wandouuu/macroWAN/README.md

# vWAN-micropad
PCB design for personal macropad!
