wandouuu/macroWAN/macroWAN/vWAN-macropad.step

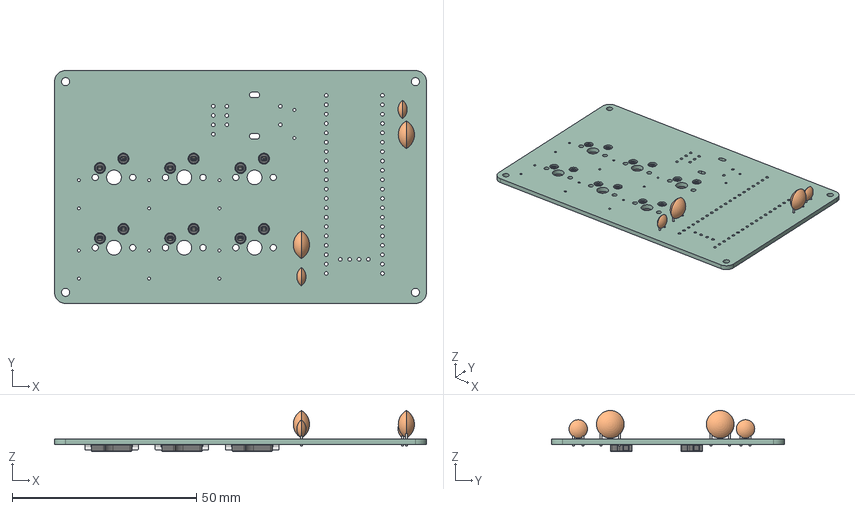
[picture p1: CAD file, 2025-09-18]
macroWAN/vWAN-macropad.step
100.8 x 63.1 x 11.1 mm
C_Disc_D7.5mm_W4.4mm_P5.00mm x 2
C_Disc_D5.0mm_W2.5mm_P2.50mm x 2
MX-Hotswap-Socket x 6
vWAN-macropad_PCB
