wandouuu/macroWAN/macroWAN/vWAN-macropad.kicad_pcb

## KiCad design macroWAN/vWAN-macropad.kicad_pcb (2026-01-08)

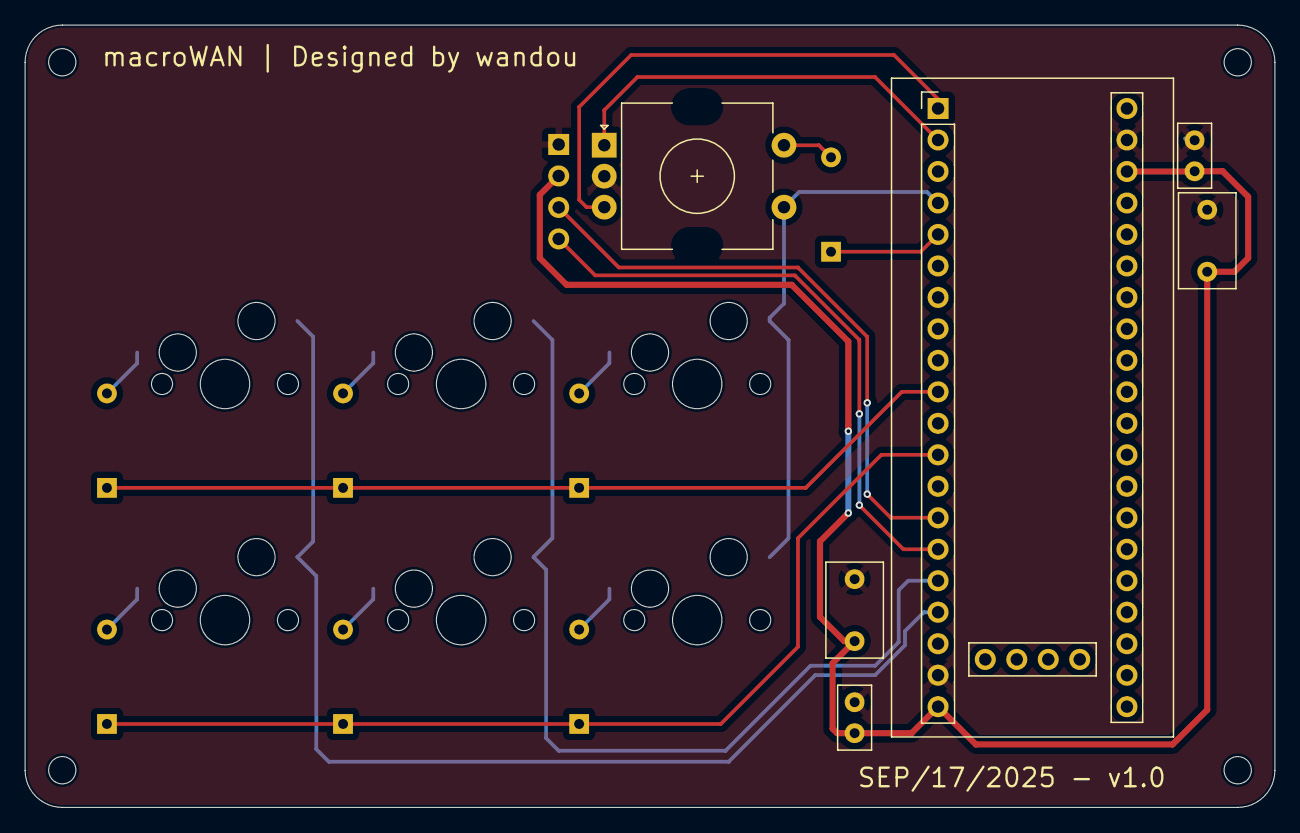
[picture p2: board vWAN-macropad.kicad_pcb from above]

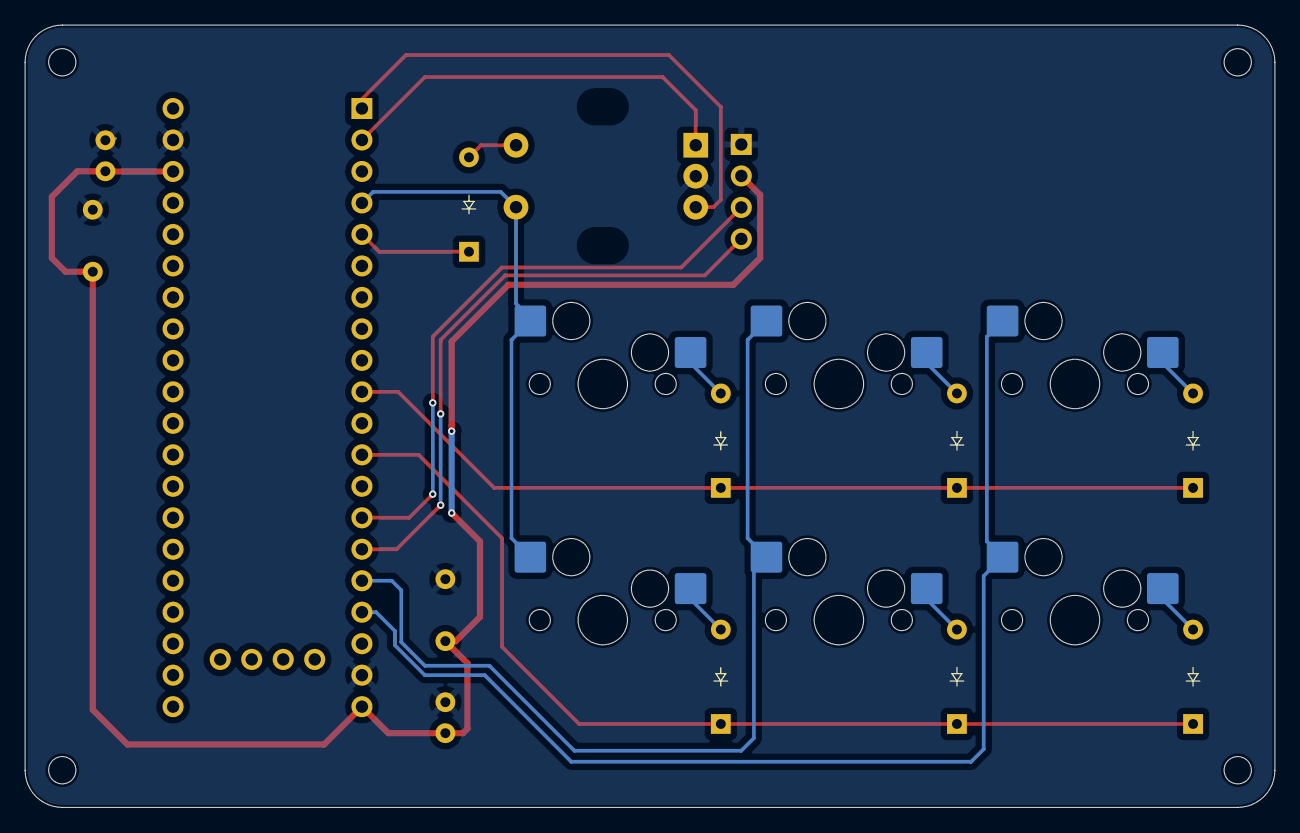
[picture p3: board vWAN-macropad.kicad_pcb from below]

Board: 2 copper layers, 100.8 x 63.1 mm, 24 parts (13 on the bottom side), 19 nets.

Parts:
C1, C2: 0.1uF; C_Disc_D5.0mm_W2.5mm_P2.50mm
C3, C4: 2.2uF; C_Disc_D7.5mm_W4.4mm_P5.00mm
D1, D2, D3, D4, D5, D6, D7: Diode; Diode_DO-35
H1, H2, H3, H4: MountingHole_Pad; MountingHole_2.2mm_M2_ISO7380
J1: OLED_128x32
SW1, SW2, SW3, SW4, SW5, SW6: Switch; MX-Hotswap-1U
SW7: RotaryEncoder_Switch; RotaryEncoder_EC11
U1: YAAJ_WeAct_BlackPill_Part_Like_SWD_Breakout; YAAJ_WeAct_BlackPill_SWD_2

Connections:
+3.3V: C1.2, C2.2, C3.2, C4.2, J1.2 (VCC), U1.20 (3V3), U1.38 (3V3)
Col 0: SW1.2, SW4.2, U1.17 (PB9)
Col 1: SW2.2, SW5.2, U1.16 (PB8)
Col 2: SW3.2, SW6.2, SW7.S1, U1.4 (PB15)
ENC_A: SW7.A, U1.2 (PB13)
ENC_B: SW7.B, U1.1 (PB12)
GND: C1.1, C2.1, C3.1, C4.1, J1.1 (GND), SW7.C, U1.19 (GND), U1.39 (GND)
unnamed: D1.2 (A), SW1.1
unnamed: D2.2 (A), SW2.1
unnamed: D3.2 (A), SW3.1
unnamed: D4.2 (A), SW4.1
unnamed: D5.2 (A), SW5.1
unnamed: D6.2 (A), SW6.1
unnamed: D7.2 (A), SW7.S2
Row 0: D7.1 (K), U1.5 (PA8)
Row 1: D1.1 (K), D2.1 (K), D3.1 (K), U1.10 (PA15)
Row 2: D4.1 (K), D5.1 (K), D6.1 (K), U1.12 (PB4)
SCL-SCK: J1.3 (SCL), U1.14 (PB6)
SDA: J1.4 (SDA), U1.15 (PB7)
