wandouuu/macroWAN/firmware/Core/Src/main.c

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
/* Includes ------------------------------------------------------------------*/
#include "main.h"


/* USER CODE BEGIN Includes */
#include "matrix_scan.h"
#include "encoder_scan.h"
#include "usb_device.h"
#include "ssd1306.h"
#include <macropad_USB_handler.h>
#include "stdbool.h"
/* USER CODE END Includes */

I2C_HandleTypeDef hi2c1;

/* USER CODE BEGIN PV */
uint8_t previous_volume = 255;
volatile uint8_t current_volume = 0;
volatile bool volume_flag = false;
uint32_t encoder_previous_time = 0;
uint8_t encoder_release_flag = 0;
/* USER CODE END PV */

void SystemClock_Config(void);
static void MX_GPIO_Init(void);
static void MX_I2C1_Init(void);
/**
  * @brief  The application entry point.
  * @retval int
  */
int main(void)
{

  /* USER CODE BEGIN 1 */
  uint32_t previous_tick = 0;
  
  /* USER CODE END 1 */

  /* MCU Configuration--------------------------------------------------------*/

  /* Reset of all peripherals, Initializes the Flash interface and the Systick. */
  HAL_Init();

  /* Configure the system clock */
  SystemClock_Config();

  /* Initialize all configured peripherals */
  MX_GPIO_Init();
  MX_I2C1_Init();
  MX_USB_DEVICE_Init();
  /* USER CODE BEGIN 2 */
  keypad_init();
  ssd1306_Init();
  /* USER CODE END 2 */

  /* Infinite loop */
  /* USER CODE BEGIN WHILE */
  while (1)
  {
    // Scan keypad matrix
    uint32_t current_tick = HAL_GetTick();
    if(current_tick - previous_tick > 0){
      matrix_scan();
      encoder_scan();

      if(encoder_release_flag && (HAL_GetTick() - encoder_previous_time) > 10){
        send_encoder_HID_report(0x00);
        encoder_release_flag = 0;
      }

      previous_tick = current_tick;
    }

    
    
  
    // Update display with value if different
    if(volume_flag && current_volume != previous_volume){
      update_display(current_volume);
      previous_volume = current_volume;
      volume_flag = false;
    }

    
    /* USER CODE END WHILE */
    
    /* USER CODE BEGIN 3 */
  }
  /* USER CODE END 3 */
}

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
