wandouuu/macroWAN/firmware/macroWAN_firmware.ioc

Mcu.UserName=STM32F411CEUx
PA11.Signal=USB_OTG_FS_DM
PA12.Signal=USB_OTG_FS_DP
PA13.Signal=SYS_JTMS-SWDIO
PA14.Signal=SYS_JTCK-SWCLK
PA15.GPIO_Label=ROW1
PA15.Signal=GPIO_Input
PA8.GPIO_Label=ROW0
PA8.Signal=GPIO_Input
PB12.GPIO_Label=ENCA
PB12.Signal=GPIO_Input
PB13.GPIO_Label=ENCB
PB13.Signal=GPIO_Input
PB15.GPIO_Label=COL2
PB15.Signal=GPIO_Output
PB4.GPIO_Label=ROW2
PB4.Signal=GPIO_Input
PB6.Signal=I2C1_SCL
PB7.Signal=I2C1_SDA
PB8.GPIO_Label=COL1
PB8.Signal=GPIO_Output
PB9.GPIO_Label=COL0
PB9.Signal=GPIO_Output
