wandouuu/macroWAN/firmware/Core/Inc/main.h

#define ENCA_Pin GPIO_PIN_12
#define ENCA_GPIO_Port GPIOB
#define ENCB_Pin GPIO_PIN_13
#define ENCB_GPIO_Port GPIOB
#define COL2_Pin GPIO_PIN_15
#define COL2_GPIO_Port GPIOB
#define ROW0_Pin GPIO_PIN_8
#define ROW0_GPIO_Port GPIOA
#define ROW1_Pin GPIO_PIN_15
#define ROW1_GPIO_Port GPIOA
#define ROW2_Pin GPIO_PIN_4
#define ROW2_GPIO_Port GPIOB
#define COL1_Pin GPIO_PIN_8
#define COL1_GPIO_Port GPIOB
#define COL0_Pin GPIO_PIN_9
#define COL0_GPIO_Port GPIOB
