wandouuu/macroWAN/firmware/Core/Inc/matrix_keypad.h

/*
 * matrix_keypad.h
 *
 *  Created on: Dec 17, 2025
 *      Author: wandouuu
 */

#ifndef INC_MATRIX_KEYPAD_H_
#define INC_MATRIX_KEYPAD_H_

#include "stm32f4xx_it.h"

// Define rows and columns
#define KEYPAD_ROWS    3
#define KEYPAD_COLS 3

// Rows
#define ROW0_GPIO_Port GPIOA
#define ROW0_Pin       GPIO_PIN_8
#define ROW1_GPIO_Port GPIOA
#define ROW1_Pin       GPIO_PIN_15
#define ROW2_GPIO_Port GPIOB
#define ROW2_Pin       GPIO_PIN_4

// Columns
#define COL0_GPIO_Port GPIOB
#define COL0_Pin       GPIO_PIN_9
#define COL1_GPIO_Port GPIOB
#define COL1_Pin       GPIO_PIN_8
#define COL2_GPIO_Port GPIOB
#define COL2_Pin       GPIO_PIN_15

#ifdef __cplusplus
extern "C" {
#endif


// Keymap matrix
static const char keymap[KEYPAD_ROWS][KEYPAD_COLS] = {
    {'\0', '\0', 'A'}, // rotary encoder
    { 'B' , 'C', 'D'}, // ROW 0
    { 'E',  'F', 'G'}  // ROW 1
};

// Initialize keypad
void Keypad_Init(void);

// Scanning
char Keypad_GetKey(void);
#ifdef __cplusplus
}
#endif

#endif /* INC_MATRIX_KEYPAD_H_ */
