wandouuu/macroWAN/firmware/Core/Src/matrix_scan.c

#include <matrix_scan.h>
#include "macropad_USB_handler.h"
#include "main.h"

// Arrays containing row ports/pins and column ports/pins
static GPIO_TypeDef* const ROW_PORT[KEYPAD_ROWS] = {
    ROW0_GPIO_Port, ROW1_GPIO_Port, ROW2_GPIO_Port
};

static const uint16_t ROW_PIN[KEYPAD_ROWS] = {
    ROW0_Pin, ROW1_Pin, ROW2_Pin
};

static GPIO_TypeDef* const COL_PORT[KEYPAD_COLS] = {
    COL0_GPIO_Port, COL1_GPIO_Port, COL2_GPIO_Port
};

static const uint16_t COL_PIN[KEYPAD_COLS] = {
    COL0_Pin, COL1_Pin, COL2_Pin
};

uint8_t keymap[KEYPAD_ROWS][KEYPAD_COLS] = {
    {0x00, 0x00, 0x00}, 
    {0x1A, 0x04, 0x11}, // W A N
    {0x06, 0x12, 0x18}  // D O U
};

uint8_t key_state[KEYPAD_ROWS][KEYPAD_COLS] = {
    {KEY_RELEASED, KEY_RELEASED, KEY_RELEASED}, // ROW 0 
    {KEY_RELEASED, KEY_RELEASED, KEY_RELEASED}, // ROW 1
    {KEY_RELEASED, KEY_RELEASED, KEY_RELEASED}  // ROW 2
    //     C0           C1            C2
};

uint8_t key_stable_state[KEYPAD_ROWS][KEYPAD_COLS] = {
    {KEY_RELEASED, KEY_RELEASED, KEY_RELEASED}, // ROW 0 
    {KEY_RELEASED, KEY_RELEASED, KEY_RELEASED}, // ROW 1
    {KEY_RELEASED, KEY_RELEASED, KEY_RELEASED}  // ROW 2
    //     C0           C1            C2
};

uint8_t key_iteration[KEYPAD_ROWS][KEYPAD_COLS] = {
    {DEBOUNCE_ITER+1, DEBOUNCE_ITER+1, DEBOUNCE_ITER+1},
    {DEBOUNCE_ITER+1, DEBOUNCE_ITER+1, DEBOUNCE_ITER+1},
    {DEBOUNCE_ITER+1, DEBOUNCE_ITER+1, DEBOUNCE_ITER+1}
};




// Set each column to high (not reading state)
void keypad_init(void){
    uint8_t i = 0;
    
    for(i = 0; i < KEYPAD_COLS; ++i){
        HAL_GPIO_WritePin(COL_PORT[i], COL_PIN[i], GPIO_PIN_SET); // Set column to high
    }

    return;
}

void matrix_scan(void){

    uint8_t new_report = 0;

    for(uint8_t c = 0; c < KEYPAD_COLS; ++c){
        
        // Set current column low to start reading row
        HAL_GPIO_WritePin(COL_PORT[c], COL_PIN[c], GPIO_PIN_RESET); // Set column to low

        for(uint8_t r = 0; r < KEYPAD_ROWS; ++r){
            
            // If the row pin reads LOW but the previous state was released
            if(HAL_GPIO_ReadPin(ROW_PORT[r], ROW_PIN[r]) == GPIO_PIN_RESET && key_state[r][c] == KEY_RELEASED){
                
                key_state[r][c] = KEY_PRESSED;
                key_iteration[r][c] = 0;

            // If the row pin reads HIGH but the previous state was pressed
            } else if(HAL_GPIO_ReadPin(ROW_PORT[r], ROW_PIN[r]) == GPIO_PIN_SET && key_state[r][c] == KEY_PRESSED){ // 
                
                key_state[r][c] = KEY_RELEASED;
                key_iteration[r][c] = 0;

            // If the row pin reads HIGH and the previous state was pressed
            } else{
                
                // Still unstable, check next
                if(key_iteration[r][c] < DEBOUNCE_ITER){
                    key_iteration[r][c]++;

                // Valid click!
                } else if(key_iteration[r][c] == DEBOUNCE_ITER){
                    key_iteration[r][c]++;
                    
                    key_stable_state[r][c] = key_state[r][c];

                    new_report = 1;
                }

            }
        }

        // Set current column back to high to stop reading row
        HAL_GPIO_WritePin(COL_PORT[c], COL_PIN[c], GPIO_PIN_SET);

    }

    // Only sends a new report if button is clicked
    if(new_report == 1){
        send_matrix_HID_report();   
    }
    

}
