wandouuu/macroWAN/(commit log)

2025-07-10 Add schematic and PCB layout files
    [vWAN-macropad.kicad_pcb, vWAN-macropad.kicad_sch]
2025-07-10 Add Blackpill v3.1 schematic
    [vWAN-macropad.kicad_sch]
2025-07-17 Add submodules and edit schematics
    [vWAN-macropad.kicad_sch]
2025-08-15 Update schematic + PCB files
    [vWAN-macropad.kicad_pcb, vWAN-macropad.kicad_sch]
2025-08-16 Update preliminary trace arrangement
    [vWAN-macropad.kicad_pcb]
2025-08-16 Edit project files
    [vWAN-macropad.kicad_sch]
2025-08-18 Edit near final schematic + PCB
    [vWAN-macropad.kicad_pcb, vWAN-macropad.kicad_sch]
2026-01-04 Add custom report descriptor and report OUT interrupt
2026-01-04 Corrected prev and curr volume variables
    [main.c]
2026-01-04 Corrected prev + curr vol and flag
    [main.c]
2026-01-08 Add finalized loop for matrix, encoder, OLED
2026-01-08 Add finalized firmware
    [bom.csv, designators.csv, positions.csv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]
