wandouuu/macroWAN/(notices)

Notices in the files:
firmware/Core/Inc/main.h:
Copyright (c) 2025 STMicroelectronics.
All rights reserved.
This software is licensed under terms that can be found in the LICENSE file
macroWAN/vWAN-macropad.kicad_pcb:
microWAN © 2025 by Brendan Leung is licensed under CC BY-NC-SA 4.0
